pictographer/didah/docs/pics/pda_components.jpg

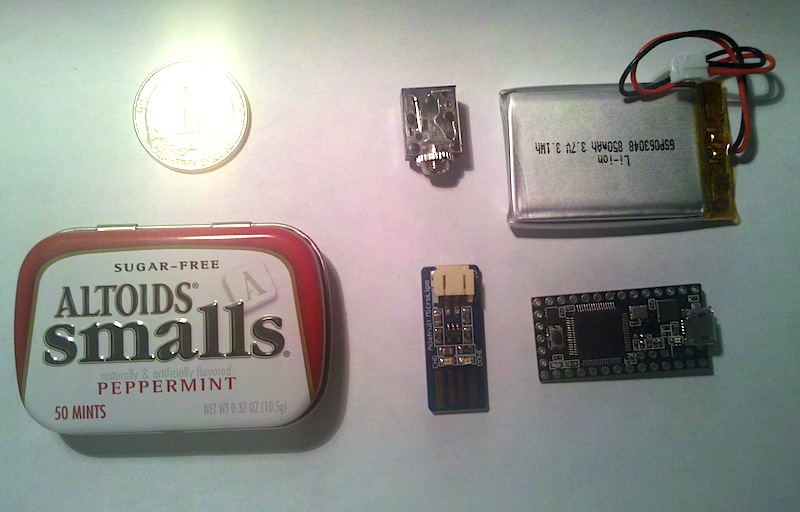
docs/pics/pda_components.jpg
