pictographer/didah/docs/pics/voltage_monitor_interior.jpg

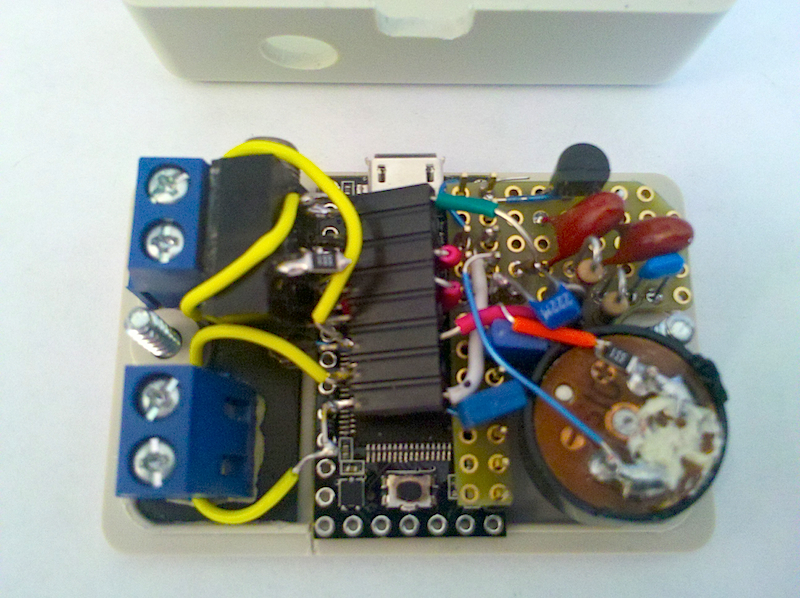
docs/pics/voltage_monitor_interior.jpg
