pictographer/didah/docs/pics/pda_exterior.jpg

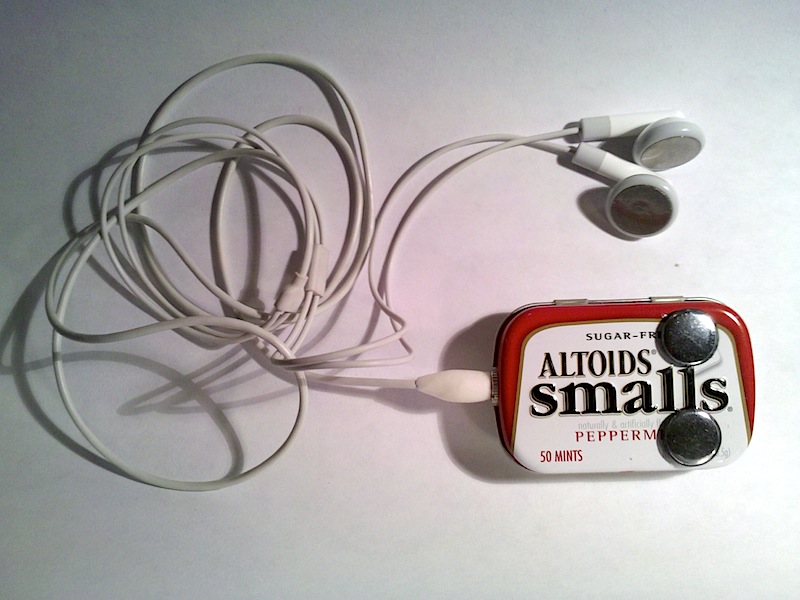
docs/pics/pda_exterior.jpg
