pictographer/didah/docs/pics/pda_interior.jpg

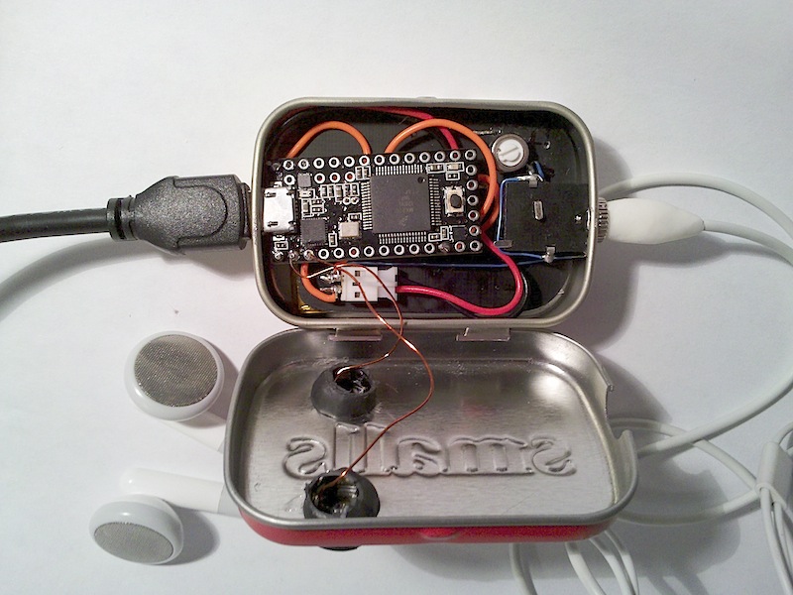
docs/pics/pda_interior.jpg
