pictographer/didah/docs/pics/voltage_monitor_action.jpg

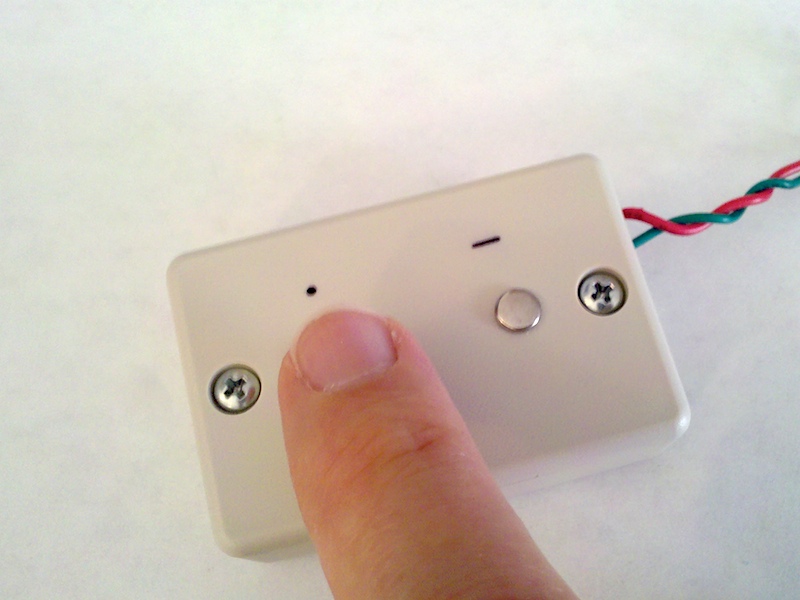
docs/pics/voltage_monitor_action.jpg
