pictographer/didah/docs/pics/voltage_monitor_bottom.jpg

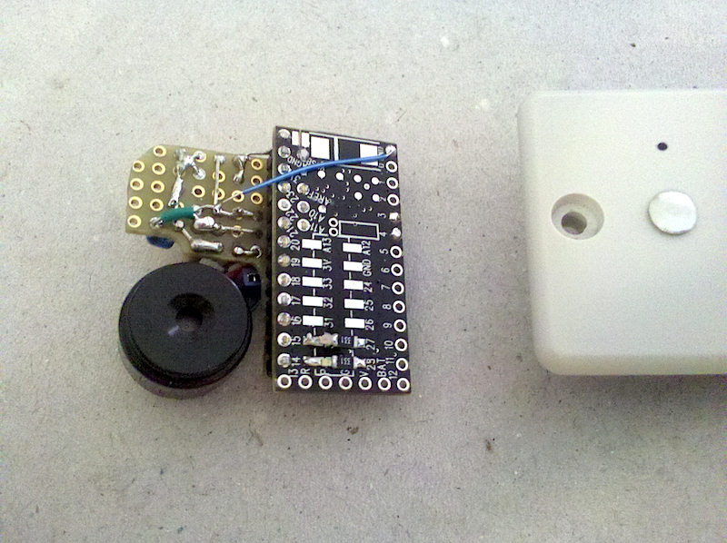
docs/pics/voltage_monitor_bottom.jpg
