pictographer/didah/docs/pics/voltage_monitor_ports.jpg

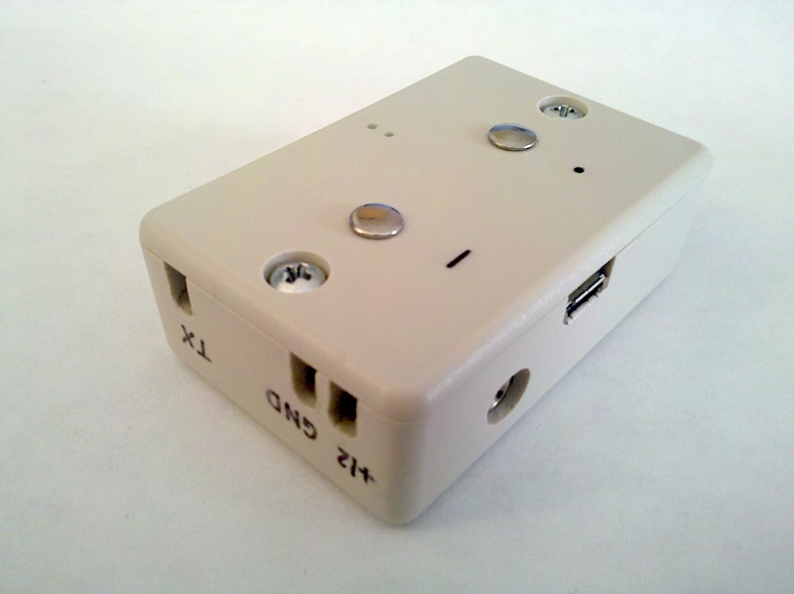
docs/pics/voltage_monitor_ports.jpg
