pictographer/didah/docs/schematic/didah_schematic.png

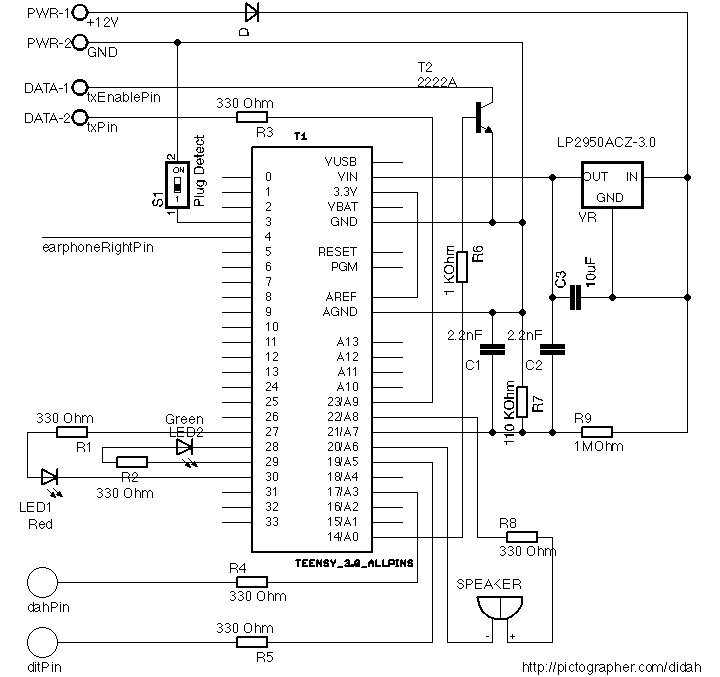
docs/schematic/didah_schematic.png
