pictographer/didah/docs/schematic/didah.pdf

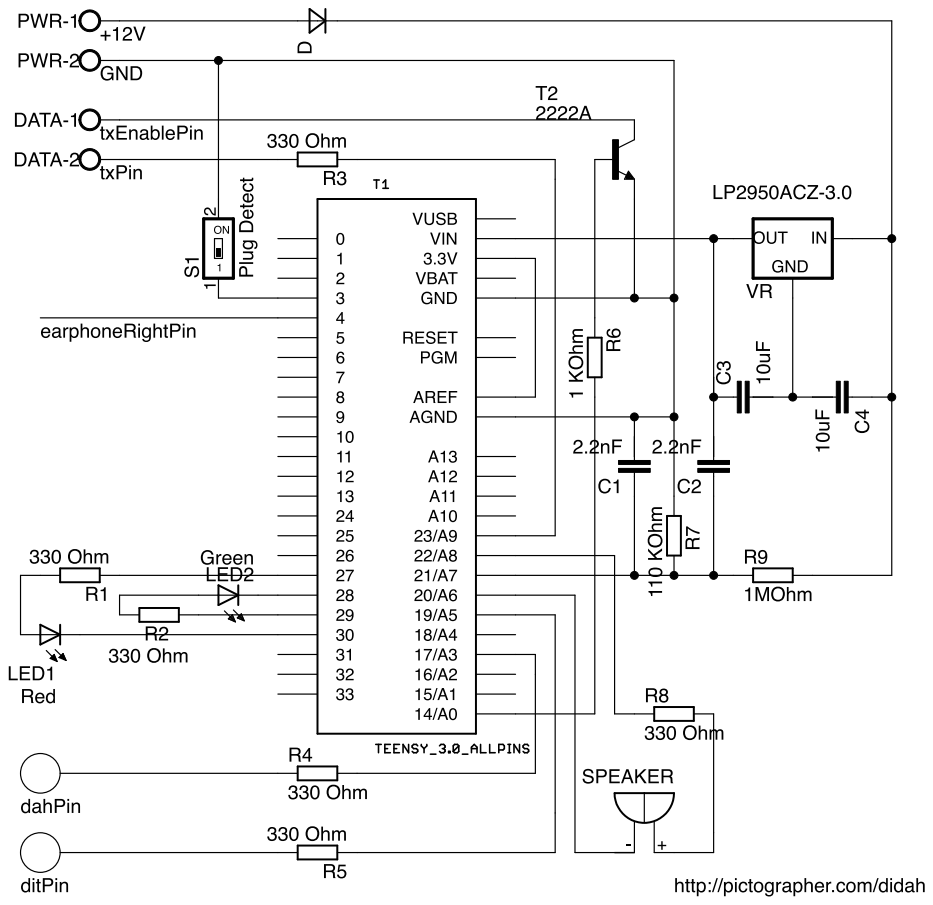
[picture p9: page 1]
