pictographer/didah/docs/schematic/didah.sch

## EAGLE design docs/schematic/didah.sch (2013-09-19)

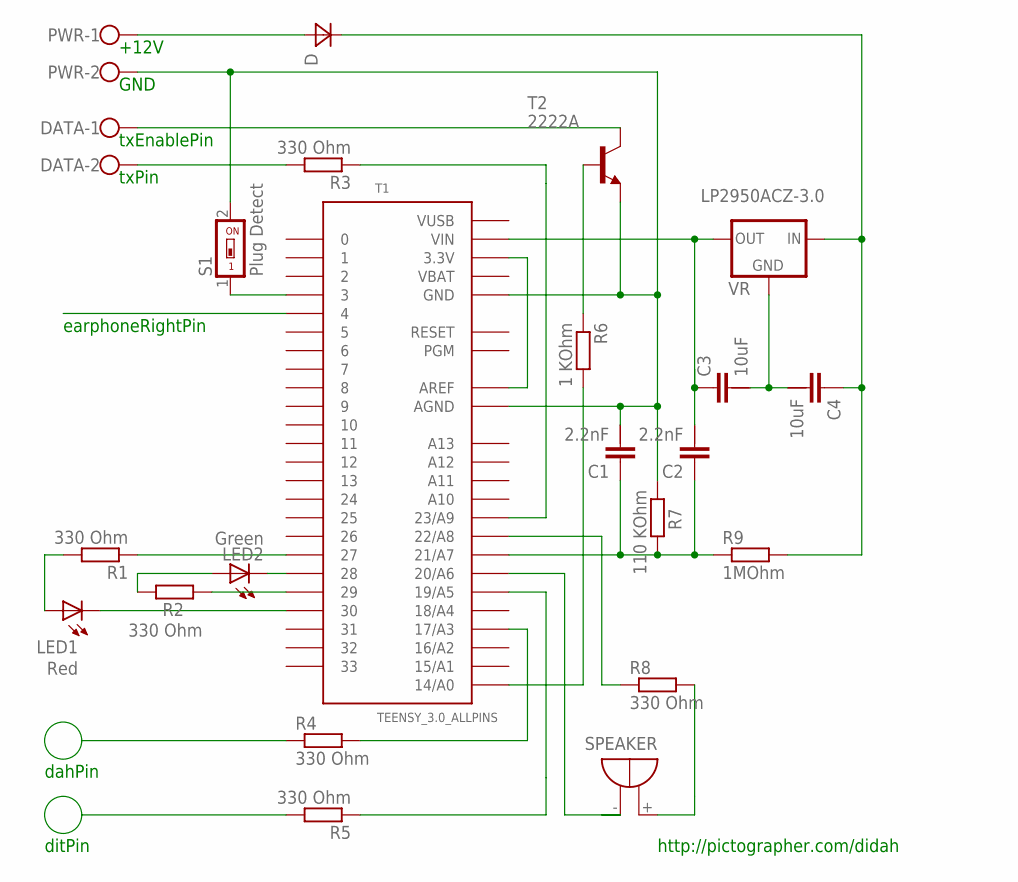
[picture p10: schematic didah.sch]

Parts:
C1, C2: 2.2nF; C2.5/5-6
C3, C4: 10uF; C2.5/5-6
D: DIODE
DATA: W237-102
LED1: Red; LED_SML0603
LED2: Green; LED_SML0603
PWR: W237-102
R1, R2, R3, R4, R5, R8: 330 Ohm; R0402
R6: 1 KOhm; R0402
R7: 110 KOhm; 0204/7
R9: 1MOhm; 0204/7
S1: Plug Detect; SMS-001
SPEAKER: BMT1205XH7.5
T1: TEENSY_3.0_ALLPINS
T2: 2222A; TO92-EBC
VR: LP2950ACZ-3.0; TO92

Connections:
unnamed: R1.1, T1.27
unnamed: LED2.A, R2.2
unnamed: C2.2, C3.1, T1.VIN, VR.1 (OUT)
unnamed: LED1.C, T1.30
unnamed: LED1.A, R1.2
unnamed: LED2.C, T1.28
unnamed: R2.1, T1.29
unnamed: C4.1, D.A, R9.2, VR.3 (IN)
unnamed: C3.2, C4.2, VR.2 (GND)
unnamed: C1.1, C2.1, R7.2, R9.1, T1.21/A7
unnamed: D.C, PWR.1
unnamed: R8.2, SPEAKER.+
unnamed: T1.3.3V, T1.AREF
unnamed: SPEAKER.-, T1.20/A6
unnamed: R8.1, T1.22/A8
unnamed: R3.1, T1.23/A9
unnamed: DATA.2, R3.2
unnamed: R4.2, T1.17/A3
unnamed: R5.1, T1.19/A5
unnamed: S1.1, T1.3
unnamed: R6.2, T1.14/A0
unnamed: DATA.1, T2.C
unnamed: R6.1, T2.B
unnamed: C1.2, PWR.2, R7.1, S1.2, T1.AGND, T1.GND, T2.E

Notes on the sheet:
txPin
ditPin
dahPin
earphoneRightPin
http://pictographer.com/didah
txEnablePin
GND
+12V
