pictographer/didah/cpu.h

#pragma once
///\file cpu.h Macros for identifying the CPU.
// From MK20DZ10.h

/* SDID Bit Fields */
#define SIM_SDID_PINID_MASK                      0xFu
#define SIM_SDID_PINID_SHIFT                     0
#define SIM_SDID_PINID(x)                        (((uint32_t)(((uint32_t)(x))<<SIM_SDID_PINID_SHIFT))&SIM_SDID_PINID_MASK)
#define SIM_SDID_FAMID_MASK                      0x70u
#define SIM_SDID_FAMID_SHIFT                     4
#define SIM_SDID_FAMID(x)                        (((uint32_t)(((uint32_t)(x))<<SIM_SDID_FAMID_SHIFT))&SIM_SDID_FAMID_MASK)
#define SIM_SDID_REVID_MASK                      0xF000u
#define SIM_SDID_REVID_SHIFT                     12
#define SIM_SDID_REVID(x)                        (((uint32_t)(((uint32_t)(x))<<SIM_SDID_REVID_SHIFT))&SIM_SDID_REVID_MASK)
// [...]

/* ----------------------------------------------------------------------------
   -- SIM
   ---------------------------------------------------------------------------- */

/**
 * @addtogroup SIM_Peripheral SIM
 * @{
 */

/** SIM - Peripheral register structure */
typedef struct SIM_MemMap {
  uint32_t SOPT1;                                  /**< System Options Register 1, offset: 0x0 */
  uint8_t RESERVED_0[4096];
  uint32_t SOPT2;                                  /**< System Options Register 2, offset: 0x1004 */
  uint8_t RESERVED_1[4];
  uint32_t SOPT4;                                  /**< System Options Register 4, offset: 0x100C */
  uint32_t SOPT5;                                  /**< System Options Register 5, offset: 0x1010 */
  uint32_t SOPT6;                                  /**< System Options Register 6, offset: 0x1014 */
  uint32_t SOPT7;                                  /**< System Options Register 7, offset: 0x1018 */
  uint8_t RESERVED_2[8];
  uint32_t SDID;                                   /**< System Device Identification Register, offset: 0x1024 */
  uint32_t SCGC1;                                  /**< System Clock Gating Control Register 1, offset: 0x1028 */
  uint32_t SCGC2;                                  /**< System Clock Gating Control Register 2, offset: 0x102C */
  uint32_t SCGC3;                                  /**< System Clock Gating Control Register 3, offset: 0x1030 */
  uint32_t SCGC4;                                  /**< System Clock Gating Control Register 4, offset: 0x1034 */
  uint32_t SCGC5;                                  /**< System Clock Gating Control Register 5, offset: 0x1038 */
  uint32_t SCGC6;                                  /**< System Clock Gating Control Register 6, offset: 0x103C */
  uint32_t SCGC7;                                  /**< System Clock Gating Control Register 7, offset: 0x1040 */
  uint32_t CLKDIV1;                                /**< System Clock Divider Register 1, offset: 0x1044 */
  uint32_t CLKDIV2;                                /**< System Clock Divider Register 2, offset: 0x1048 */
  uint32_t FCFG1;                                  /**< Flash Configuration Register 1, offset: 0x104C */
  uint32_t FCFG2;                                  /**< Flash Configuration Register 2, offset: 0x1050 */
  uint32_t UIDH;                                   /**< Unique Identification Register High, offset: 0x1054 */
  uint32_t UIDMH;                                  /**< Unique Identification Register Mid-High, offset: 0x1058 */
  uint32_t UIDML;                                  /**< Unique Identification Register Mid Low, offset: 0x105C */
  uint32_t UIDL;                                   /**< Unique Identification Register Low, offset: 0x1060 */
} volatile *SIM_MemMapPtr;

#define SIM_FCFG1_REG(base)                      ((base)->FCFG1)
#define SIM_FCFG2_REG(base)                      ((base)->FCFG2)

/* FCFG1 Bit Fields */
#define SIM_FCFG1_DEPART_MASK                    0xF00u
#define SIM_FCFG1_DEPART_SHIFT                   8
#define SIM_FCFG1_DEPART(x)                      (((uint32_t)(((uint32_t)(x))<<SIM_FCFG1_DEPART_SHIFT))&SIM_FCFG1_DEPART_MASK)
#define SIM_FCFG1_EESIZE_MASK                    0xF0000u
#define SIM_FCFG1_EESIZE_SHIFT                   16
#define SIM_FCFG1_EESIZE(x)                      (((uint32_t)(((uint32_t)(x))<<SIM_FCFG1_EESIZE_SHIFT))&SIM_FCFG1_EESIZE_MASK)
#define SIM_FCFG1_PFSIZE_MASK                    0xF000000u
#define SIM_FCFG1_PFSIZE_SHIFT                   24
#define SIM_FCFG1_PFSIZE(x)                      (((uint32_t)(((uint32_t)(x))<<SIM_FCFG1_PFSIZE_SHIFT))&SIM_FCFG1_PFSIZE_MASK)
#define SIM_FCFG1_NVMSIZE_MASK                   0xF0000000u
#define SIM_FCFG1_NVMSIZE_SHIFT                  28
#define SIM_FCFG1_NVMSIZE(x)                     (((uint32_t)(((uint32_t)(x))<<SIM_FCFG1_NVMSIZE_SHIFT))&SIM_FCFG1_NVMSIZE_MASK)
/* FCFG2 Bit Fields */
#define SIM_FCFG2_MAXADDR1_MASK                  0x3F0000u
#define SIM_FCFG2_MAXADDR1_SHIFT                 16
#define SIM_FCFG2_MAXADDR1(x)                    (((uint32_t)(((uint32_t)(x))<<SIM_FCFG2_MAXADDR1_SHIFT))&SIM_FCFG2_MAXADDR1_MASK)
#define SIM_FCFG2_PFLSH_MASK                     0x800000u
#define SIM_FCFG2_PFLSH_SHIFT                    23
#define SIM_FCFG2_MAXADDR0_MASK                  0x3F000000u
#define SIM_FCFG2_MAXADDR0_SHIFT                 24
#define SIM_FCFG2_MAXADDR0(x)                    (((uint32_t)(((uint32_t)(x))<<SIM_FCFG2_MAXADDR0_SHIFT))&SIM_FCFG2_MAXADDR0_MASK)
#define SIM_FCFG2_SWAPPFLSH_MASK                 0x80000000u
#define SIM_FCFG2_SWAPPFLSH_SHIFT                31

/** @}*/
