pictographer/didah/(commit log)

2013-09-03 Update for amateur radio repeater voltage monitor
    Several months of development are captured here. Comments have been
    formatted for Doxygen.
2013-09-03 Updated README to include voltage monitor appliance.
2013-09-12 Added over-voltage alarm.
    Added over-voltage alarm, including commands to set the alarm level,
    and alarm format. Fixed ADC configuration to obtain full range.
    Replaced Morse.ino with didah.ino to fix a build error. Miscellaneous
    cleanups.
    [actions.cpp, actions.h, didah.ino, libmorse.cpp, pda.cpp, prosign.h, settings.cpp, settings.h]
2013-09-14 Fixed over-voltage alarm. Improved documentation. Fixed some mistakes in prompts. Improved response to buttons while transmitting.
    [actions.cpp, didah.ino, libmorse.cpp, pda.cpp, settings.cpp, settings.h]
2013-09-15 Increased frequency of voltage status updates. Improved alarm LED behavior. Fixed Morse erase character (SS prosign). Fixed UI incorrect maximum voltage.
    [actions.cpp, didah.ino, morse_token.cpp, prosign.h, settings.cpp, settings.h, teensy3_morse_bsp.cpp, teensy3_morse_bsp.h]
2013-09-15 Added URL. Created PDF from schematic.
    [didah.sch]
2013-09-16 Added pictures, schematic, and BOM.
2013-09-19 Added Transmit Enable (TE)
    [didah.sch]
2013-09-25 Added load command to Morse code interface. Fixed various other things.
    Made O in Morse code load the saved settings as previously documented.
    Slowed the default dit duration. Updated voltage monitor calibration.
    Made timeout for reading or copying input abort leaving the previous
    value unchanged rather than assigning a null/0 value. Fixed a prompt
    for the high voltage threshold that said "low". Made the command to
    report the top of the stack first pop the command token off the stack.
    Removed the QSR command to avoid confusion with QRS. Made the radix for
    string to integer conversion explicitly 10 because there is no reason
    to support syntax like 0xA4.
    [actions.cpp, actions.h, didah.ino, settings.cpp, voltage_monitor.h]
2017-08-18 This project is C++/Arduino.
2018-04-23 Switched back to .html and added .md to included extensions
2018-04-23 Fixed picture paths back after updating Doxygen config to include pics directory
    [didah.ino]
2018-04-23 Manually copying assets
    [didah.sch]
